sv3/sinking-electronics/development/sinking_rev2.png

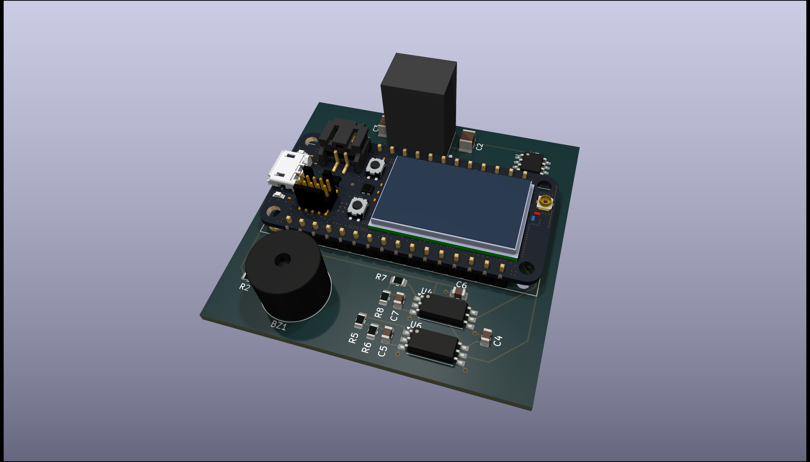
development/sinking_rev2.png
