sv3/sinking-electronics/development/float_switch_1ms.png

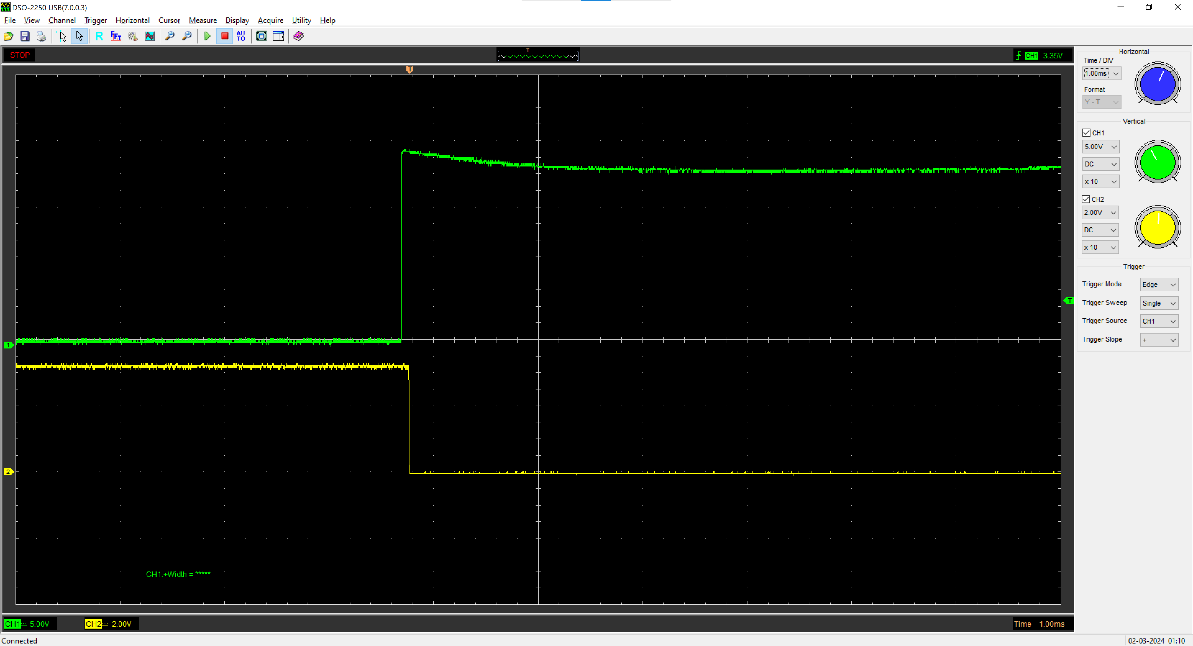
development/float_switch_1ms.png
