sv3/sinking-electronics/development/float_switch_400ms.png

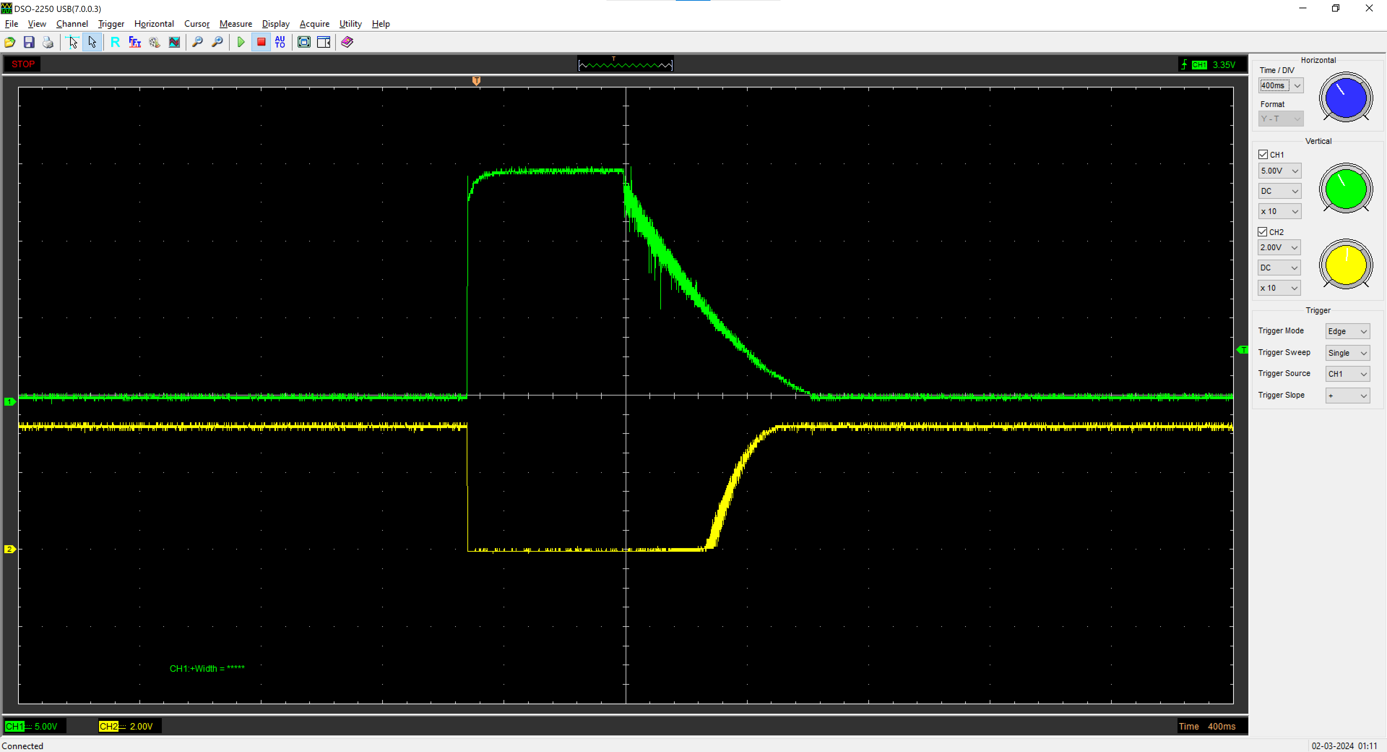
development/float_switch_400ms.png
