sv3/sinking-electronics/mechanical/MSMV2E3D_moist_sense_holder.3mf

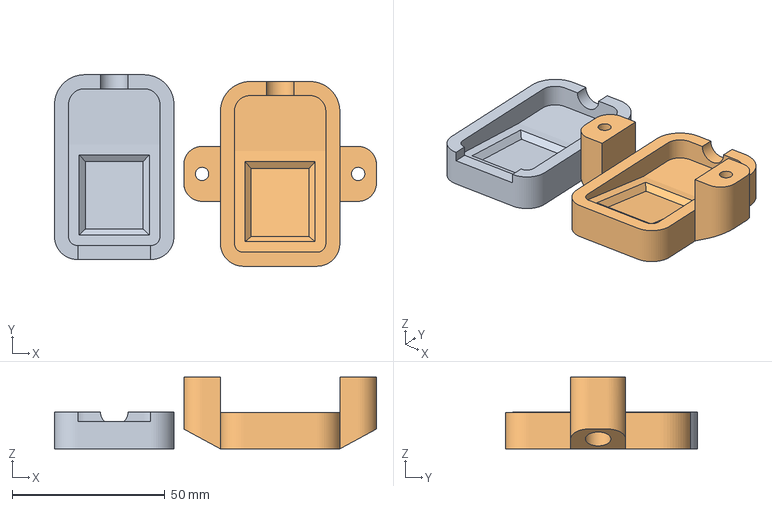
[picture p4: CAD file, 2024-02-27]
mechanical/MSMV2E3D_moist_sense_holder.3mf
105.5 x 62.8 x 23.5 mm
moist_sense_holder_bot.stl
moist_sense_holder_top.stl
