sv3/sinking-electronics/sinking.pdf

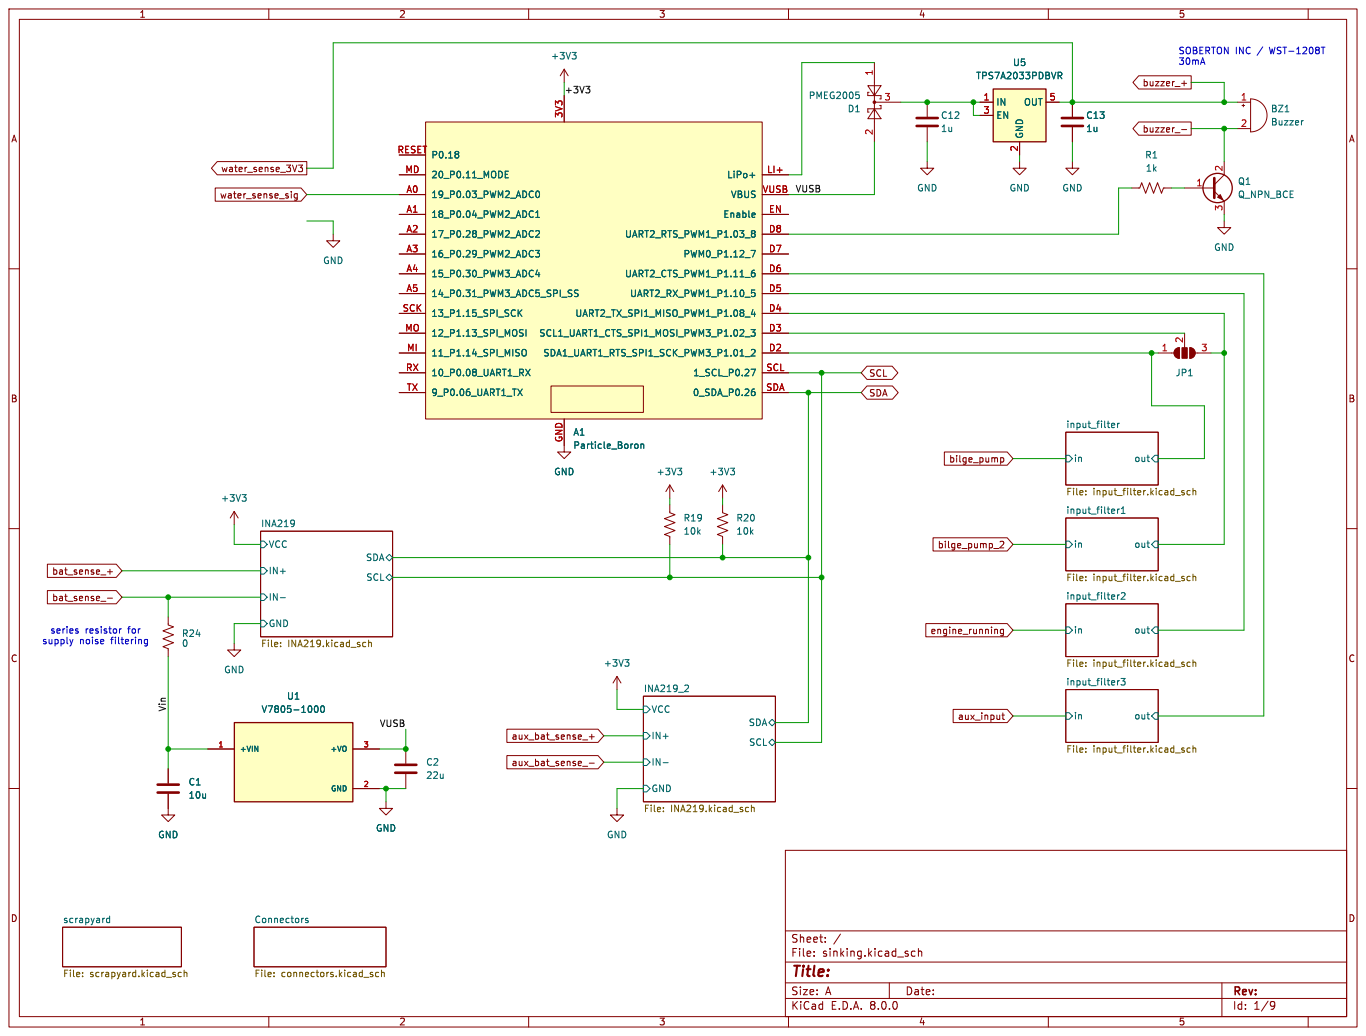
[picture p5: page 1]

input_filter1 File: input_filter.kicad_sch Connectors File: connectors.kicad_sch
INA219 File: INA219.kicad_sch

Id: 1/9 Title: File: sinking.kicad_sch Sheet: / SDA
SCL

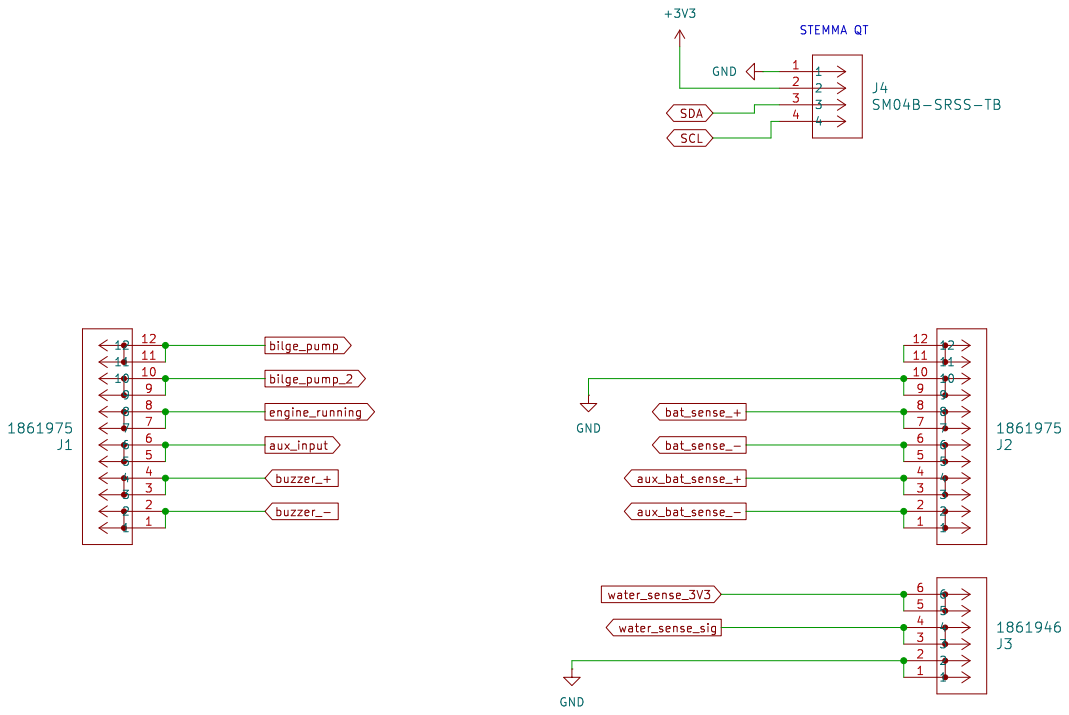
[picture p6: page 2]

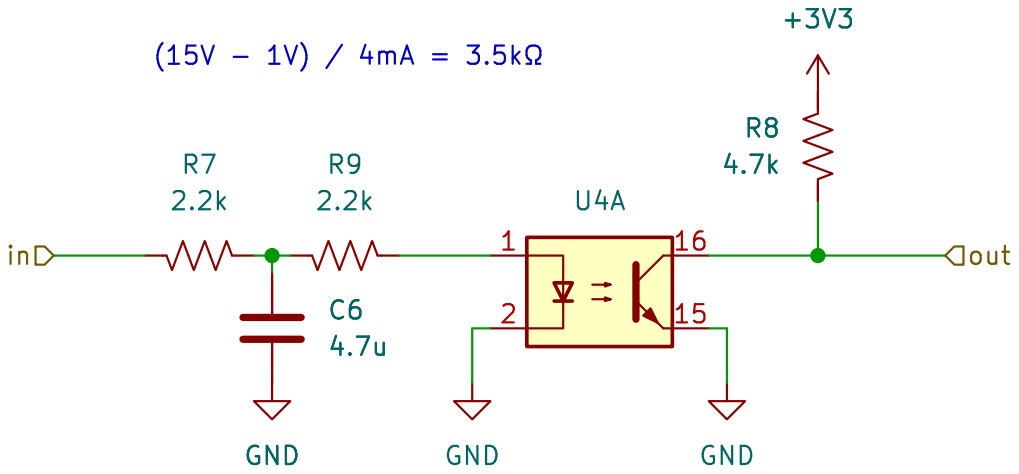
[picture p7: page 3]

Id: 3/9 Title: File: input_filter.kicad_sch Sheet: /input_filter/

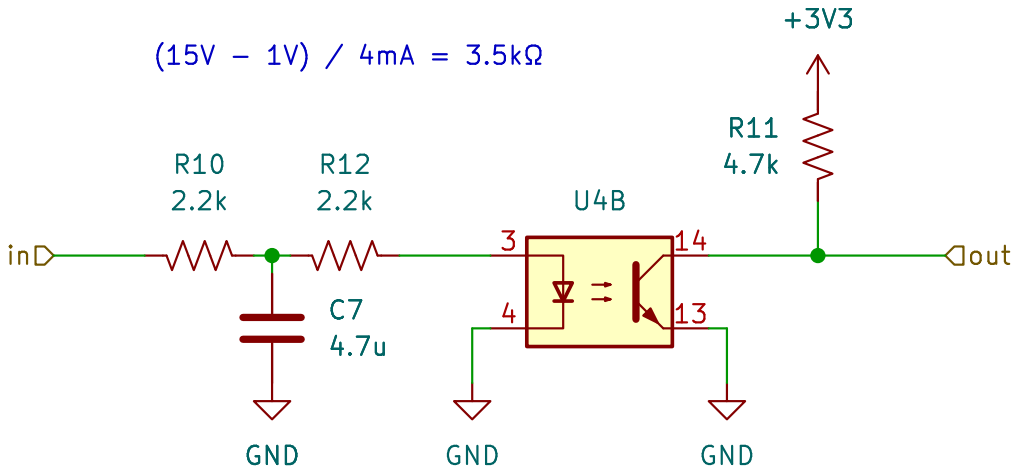
[picture p8: page 4]

Id: 4/9 Title: File: input_filter.kicad_sch Sheet: /input_filter1/

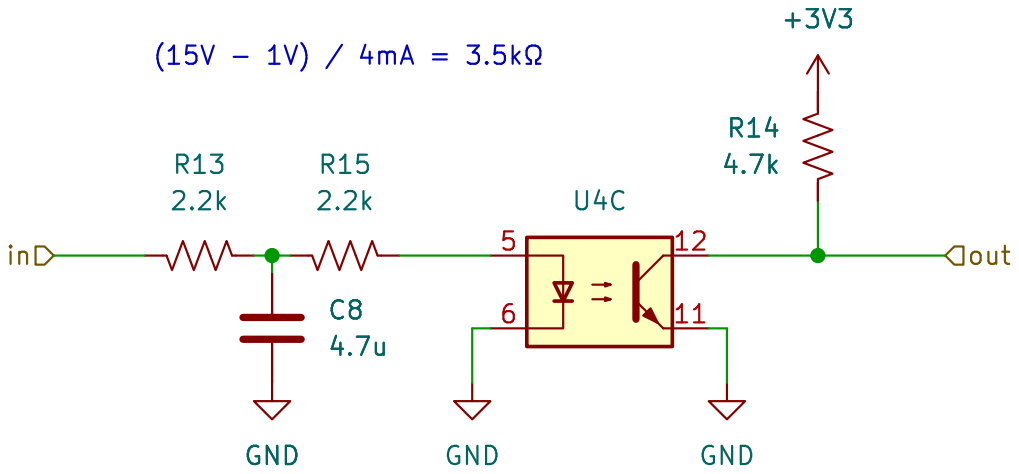
[picture p9: page 5]

Id: 5/9 Title: File: input_filter.kicad_sch Sheet: /input_filter2/

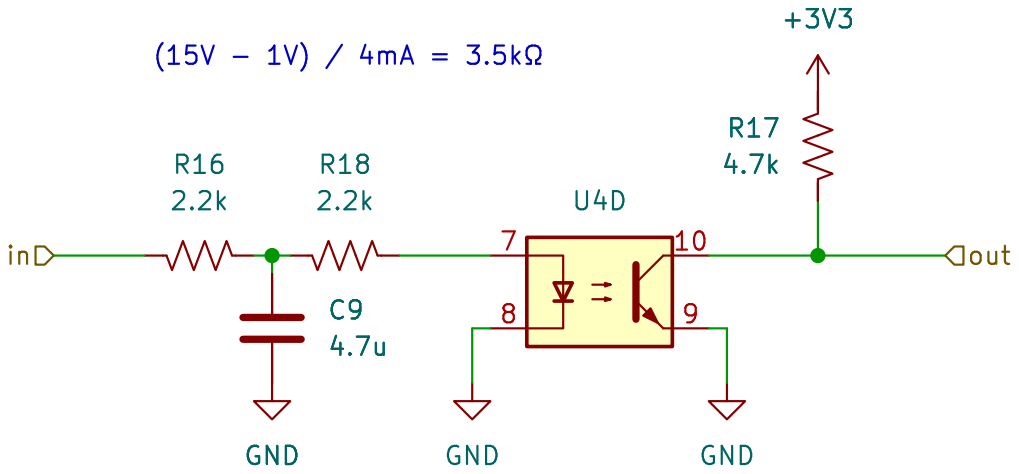
[picture p10: page 6]

Id: 6/9 Title: File: input_filter.kicad_sch Sheet: /input_filter3/

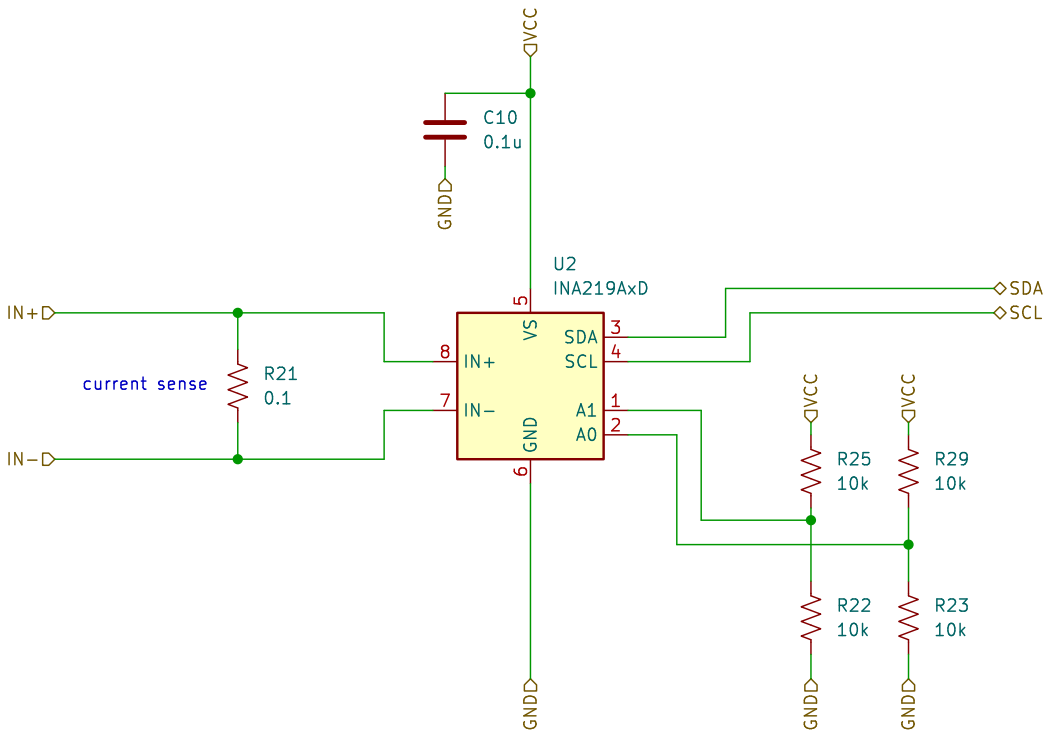
[picture p11: page 7]

Id: 7/9 Title: File: INA219.kicad_sch Sheet: /INA219/

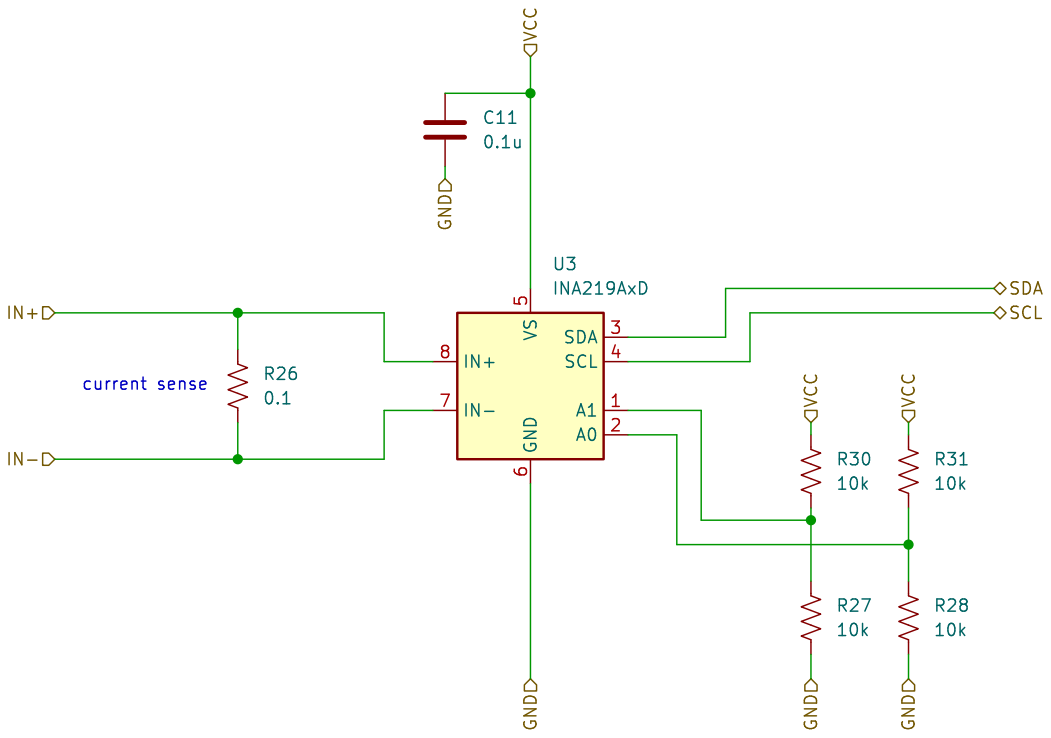
[picture p12: page 8]

Id: 8/9 Title: File: INA219.kicad_sch Sheet: /INA219_2/

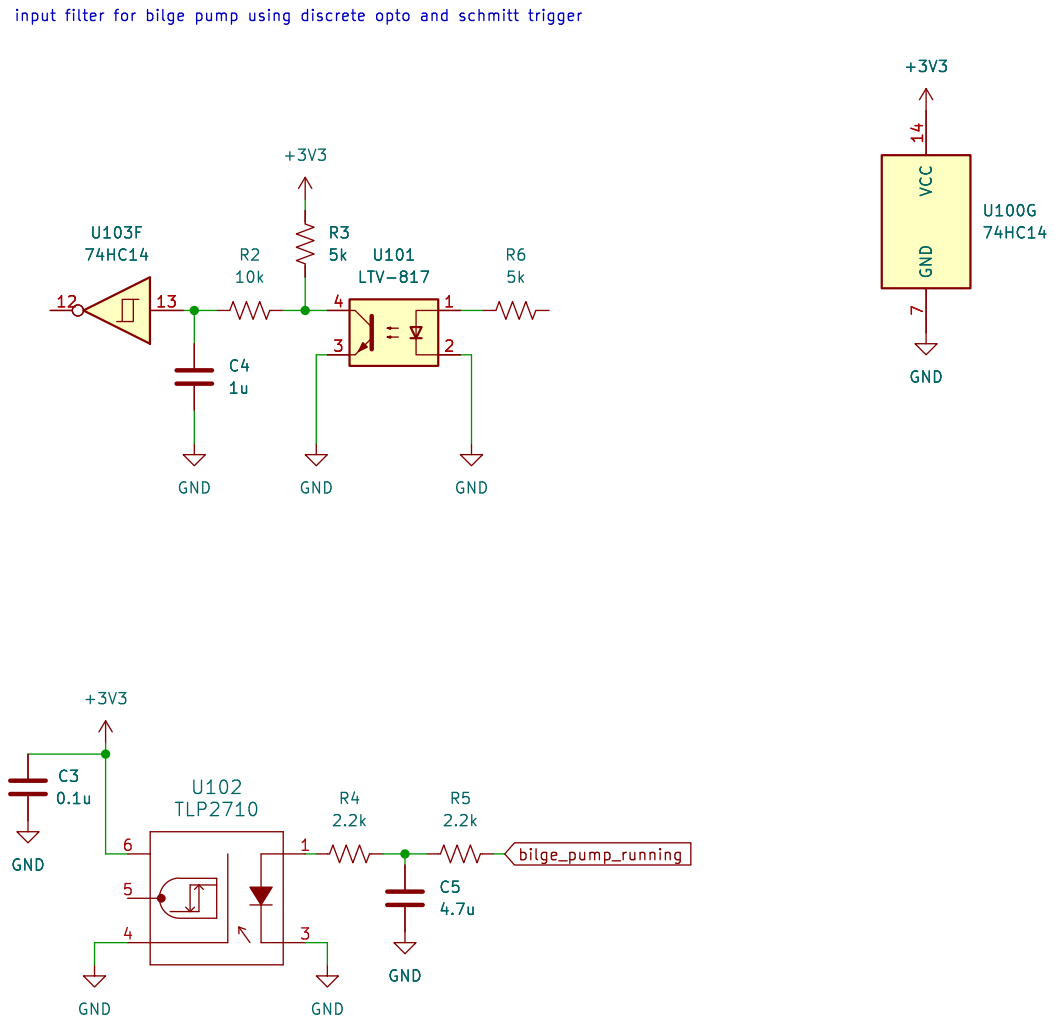
[picture p13: page 9]

Id: 9/9 Title: File: scrapyard.kicad_sch Sheet: /scrapyard/ GND
