sv3/sinking-electronics/simulation/opto_input.asc

A1: schmtinv; Vhigh=3.3 Vt=1.5 Vh=0.4
C2: cap; 1µ
R1: res; 5k
R2: res; 5k
R3: res; 10k
U1: PC817A
V1: voltage; SINE(6 6 10 0 0 100ms 100)
V2: voltage; 3.3
V3: voltage; PULSE(0 12 1ms 0 0 {T} 100ms 1)
Named nets: 0, 3V3, GPIO
.tran 0 60ms 0 0.1ms
.step param T list 1m 5m 10m 20m
