sv3/sinking-electronics/simulation/opto_input_alt.asc

A1: schmtinv; Vhigh=3.3 Vt=1.5 Vh=0.4
C1: cap; 4.7µ
C2: cap; 1µ
R1: res; 2.2k
R2: res; 2k
R3: res; 10k
R4: res; 2.2k
U1: PC817A
V1: voltage; AC 1
V2: voltage; 3.3
V3: voltage; PULSE(0 12 10ms 0 0 {T} 100ms 1)
Named nets: 0, 3V3, GPIO
.tran 0 60ms 0
.ac oct 100 10 10k
.step param T list 1m 5m 10m 20m
