sv3/sinking-electronics/simulation/opto_input_alt_2_schitt_opto.asc

A1: schmtinv; Vhigh=3.3 Vt=1.5 Vh=0.4
R1: res; 2.2k
R2: res; 10k
R4: res; 2.2k
U2: TLP2366
V1: voltage; PWL(0 0 20m 12 40m 0); AC 1
V2: voltage; 3.3
V3: voltage; SINE(0 0.7 5000)
Named nets: 0, 3V3, GPIO
.tran 0 40ms 0 0.1ms
.ac oct 100 10 10k
.step param T list 1m 5m 10m
.step param V_init linear 0v 3v 10
