sv3/sinking-electronics/sinking.kicad_pcb

## KiCad design sinking.kicad_pcb (2024-04-26)

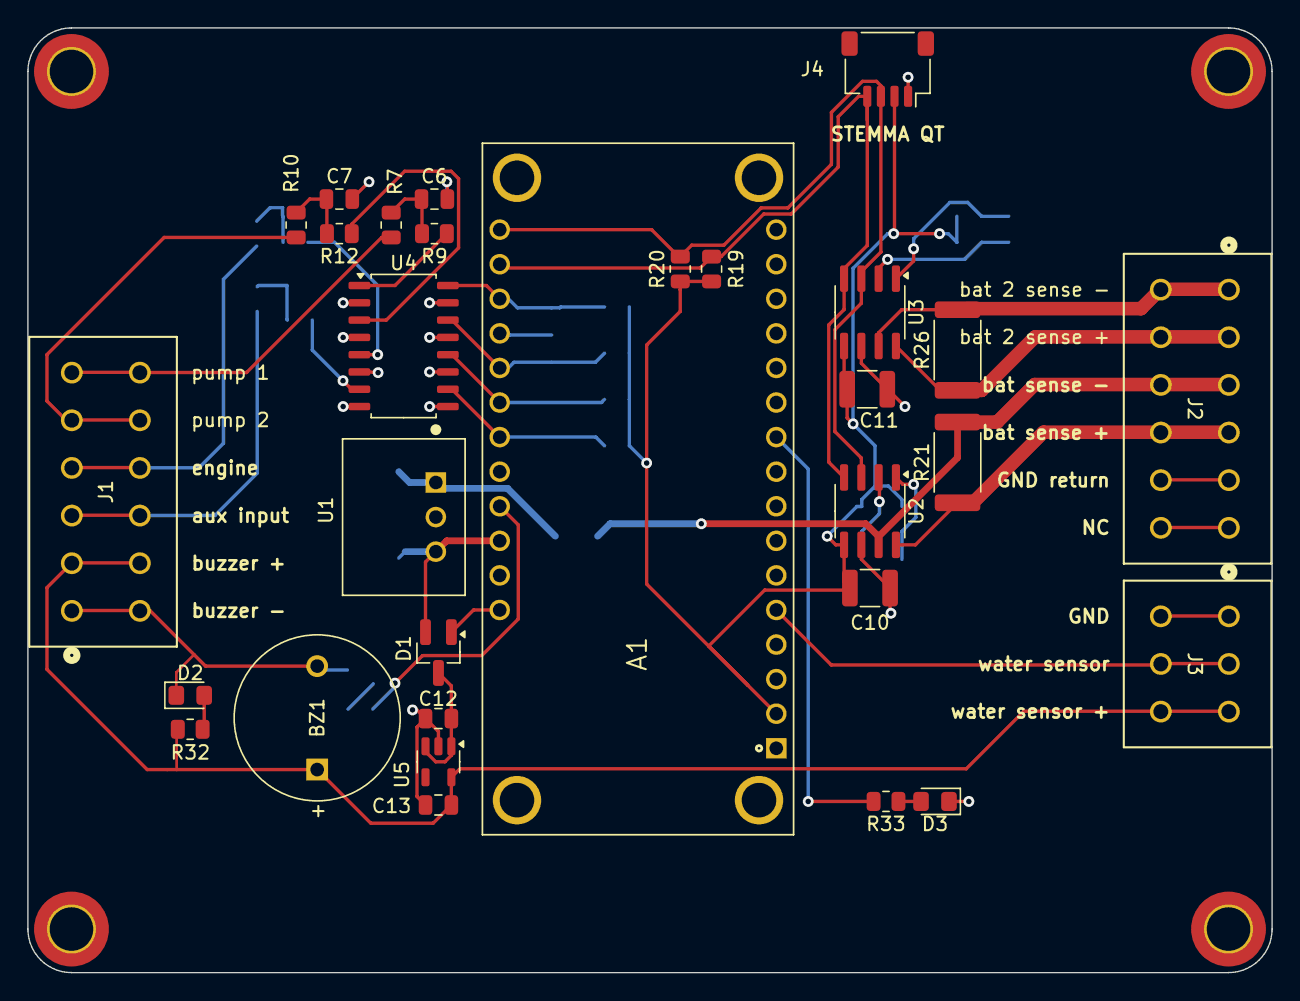
[picture p14: board sinking.kicad_pcb from above]

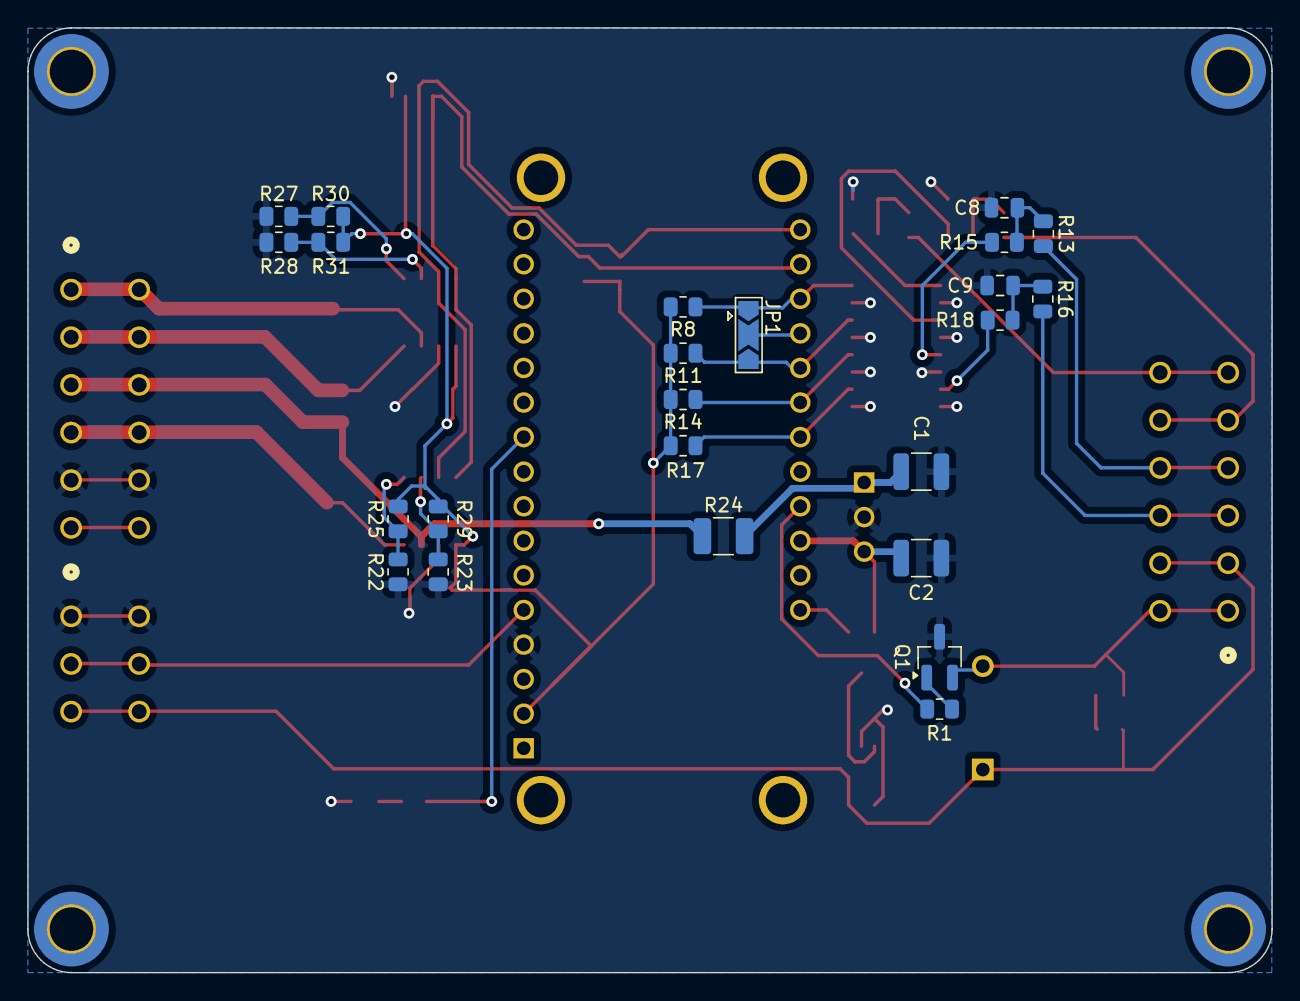
[picture p15: board sinking.kicad_pcb from below]

Board: 2 copper layers, 91.4 x 69.4 mm, 54 parts (24 on the bottom side), 42 nets.

Parts:
A1: Particle_Boron; Boron
BZ1: Buzzer; MagneticBuzzer_ProSignal_ABI-009-RC
C1: 10u; C_1210_3225Metric
C2: 22u; C_1210_3225Metric
C6, C7, C8, C9: 4.7u; C_0805_2012Metric
C10, C11: 0.1u; C_1210_3225Metric
C12, C13: 1u; C_0805_2012Metric
D1: PMEG2005; SOT-23_Handsoldering
D2: CTL0805FRD1T; LED_0805_2012Metric_Pad1.15x1.40mm_HandSolder
D3: LED; LED_0805_2012Metric_Pad1.15x1.40mm_HandSolder
J1, J2: 1861975; CONN_1861975
J3: 1861946; CONN_1861946
J4: SM04B-SRSS-TB; JST_SH_SM04B-SRSS-TB_1x04-1MP_P1.00mm_Horizontal
JP1: SolderJumper_3_Open; SolderJumper-3_P2.0mm_Open_TrianglePad1.0x1.5mm
Q1: Q_NPN_BCE; SOT-23_Handsoldering
R1: 1k; R_0805_2012Metric
R7, R9, R10, R12, R13, R15, R16, R18: 2.2k; R_0805_2012Metric
R8, R11, R14, R17: 4.7k; R_0805_2012Metric
R19, R20, R22, R23, R25, R27, R28, R29, R30, R31: 10k; R_0805_2012Metric
R21, R26: 0.1; R_2512_6332Metric
R24: 0; R_1210_3225Metric_Pad1.30x2.65mm_HandSolder
R32, R33: 330; R_0805_2012Metric
U1: V7805-1000; CONV_V7805-1000
U2, U3: INA219AxD; SOIC-8_3.9x4.9mm_P1.27mm
U4: TLP291-4; SOIC-16_4.55x10.3mm_P1.27mm
U5: TPS7A2033PDBVR; SOT-23-5

Connections:
+3V3: A1.3V3, C10.1, C11.1, J4.2, R8.2, R11.2, R14.2, R17.2, R19.2, R20.2, R25.2, R29.2, R30.2, R31.2, U2.5 (VS), U3.5 (VS)
/VUSB: A1.VUSB (VBUS), C2.1, D1.2, U1.3 (+VO)
/Vin: C1.1, R24.2, U1.1 (+VIN)
/input_filter1/out: A1.D4 (UART2_TX_SPI1_MISO_PWM1_P1.08_4), JP1.3 (B), R11.1, U4.14
/input_filter2/out: A1.D5 (UART2_RX_PWM1_P1.10_5), R14.1, U4.12
/input_filter3/out: A1.D6 (UART2_CTS_PWM1_P1.11_6), R17.1, U4.10
/input_filter/out: A1.D2 (SDA1_UART1_RTS_SPI1_SCK_PWM3_P1.01_2), JP1.1 (A), R8.1, U4.16
GND: A1.GND, C1.2, C2.2, C6.2, C7.2, C8.2, C9.2, C10.2, C11.2, C12.2, C13.2, D3.1 (K), J2.9, J2.10, J3.1, J3.2, J4.1, Q1.3 (E), R22.1, R23.1, R27.1, R28.1, U1.2 (GND), U2.6 (GND), U3.6 (GND), U4.2, U4.4, U4.6, U4.8, U4.9, U4.11, U4.13, U4.15, U5.2 (GND)
unnamed: A1.A5 (14_P0.31_PWM3_ADC5_SPI_SS), R33.2
unnamed: A1.LI+ (LiPo+), D1.1
unnamed: A1.D3 (SCL1_UART1_CTS_SPI1_MOSI_PWM3_P1.02_3), JP1.2 (C)
unnamed: A1.D8 (UART2_RTS_PWM1_P1.03_8), R1.1
unnamed: C6.1, R7.1, R9.2
unnamed: C7.1, R10.1, R12.2
unnamed: C8.1, R13.1, R15.2
unnamed: C9.1, R16.1, R18.2
unnamed: D2.2 (A), R32.2
unnamed: D3.2 (A), R33.1
unnamed: J2.11, J2.12
unnamed: Q1.1 (B), R1.2
unnamed: R9.1, U4.1
unnamed: R12.1, U4.3
unnamed: R15.1, U4.5
unnamed: R18.1, U4.7
unnamed: R23.2, R29.1, U2.2 (A0)
unnamed: R22.2, R25.1, U2.1 (A1)
unnamed: R28.2, R31.1, U3.2 (A0)
unnamed: R27.2, R30.1, U3.1 (A1)
unnamed: C12.1, D1.3, U5.1 (IN), U5.3 (EN)
SCL: A1.SCL (1_SCL_P0.27), J4.4, R19.1, U2.4 (SCL), U3.4 (SCL)
SDA: A1.SDA (0_SDA_P0.26), J4.3, R20.1, U2.3 (SDA), U3.3 (SDA)
aux_bat_sense_+: J2.3, J2.4, R26.1, U3.8 (IN+)
aux_bat_sense_-: J2.1, J2.2, R26.2, U3.7 (IN-)
aux_input: J1.5, J1.6, R16.2
bat_sense_+: J2.7, J2.8, R21.1, U2.8 (IN+)
bat_sense_-: J2.5, J2.6, R21.2, R24.1, U2.7 (IN-)
bilge_pump: J1.11, J1.12, R7.2
bilge_pump_2: J1.9, J1.10, R10.2
buzzer_+: BZ1.1 (+), C13.1, J1.3, J1.4, J3.5, J3.6, R32.1, U5.5 (OUT)
buzzer_-: BZ1.2 (-), D2.1 (K), J1.1, J1.2, Q1.2 (C)
engine_running: J1.7, J1.8, R13.2
water_sense_sig: A1.A0 (19_P0.03_PWM2_ADC0), J3.3, J3.4
