sv3/sinking-electronics/development/manual_switch_1ms.png

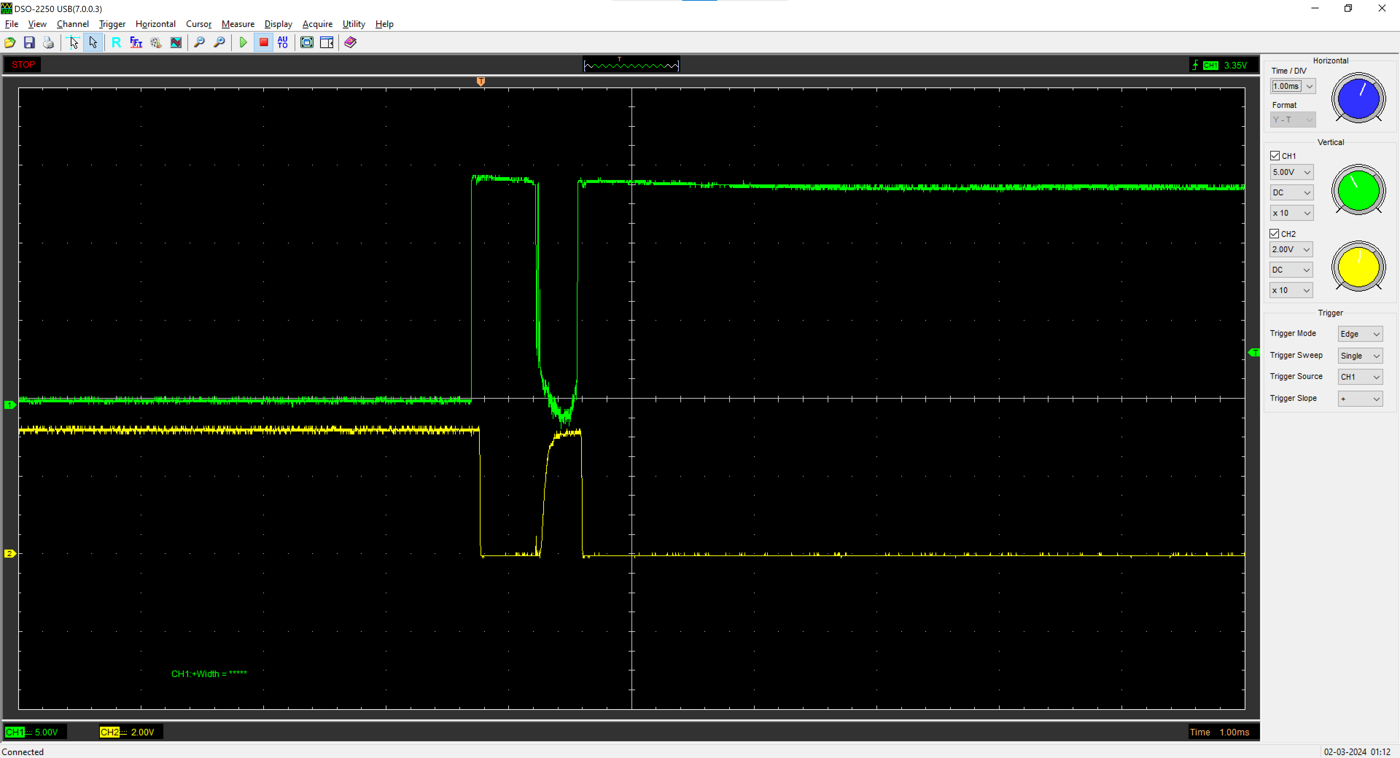
development/manual_switch_1ms.png
