sv3/sinking-electronics/development/manual_switch_400ms.png

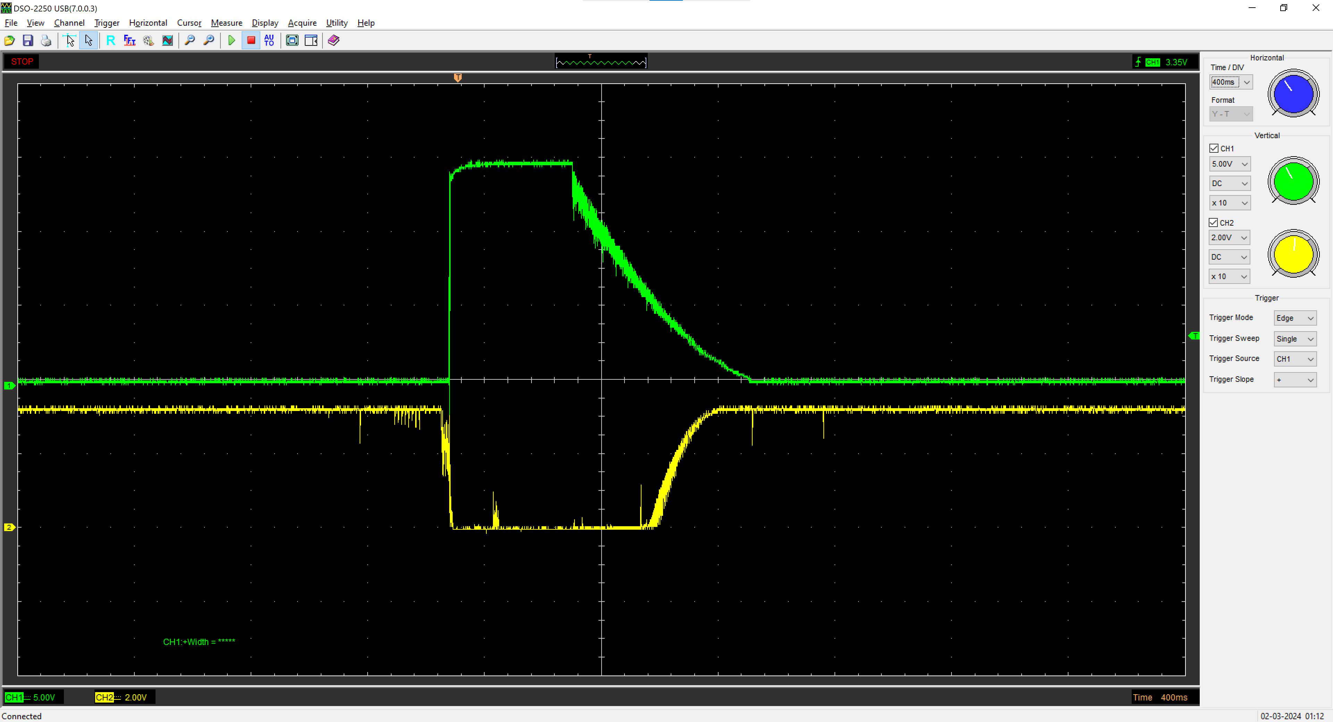
development/manual_switch_400ms.png
