sv3/sinking-electronics/(commit log)

2024-02-29 improve pump input filter. add simulation
    [sinking.kicad_pcb, sinking.kicad_sch]
2024-04-24 first layout
    [INA219.kicad_sch, connectors.kicad_sch, input_filter.kicad_sch, scrapyard.kicad_sch, sinking.kicad_pcb, sinking.kicad_sch]
2024-04-26 add status led, etc.
    [connectors.kicad_sch, sinking.kicad_pcb, sinking.kicad_sch]
